MirCore/ITS-RaspberryCar/projektbericht/projektbericht.pdf

# 0.1 import

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

9
cap = cv2 . VideoCapture ( 0 ) | # Input 0
11 | # Codec und VideoWriter o b j e c t f ür Video Output
f o u r c c = cv2 . Vide oW ri te r_ f ou rcc (∗ ’XVID ’ )
13 out = cv2 . VideoWriter ( ’ output . a vi ’ , f o u r c c , 1 5 , ( 6 4 0 , 4 8 0 ) ) r e t , img = cap . re ad ( )

## ../main.py

## Am Anfang der Hauptdatei werden die benötigten Module importiert, gefolgt von den beiden

## ausgelagerten Dateien. Von aufrauemen.py werden nur die benötigten Funktionen importiert

und von setup.py wird alles importiert, da diese Datei keine Funktion enthält.

## In den Zeilen 10 bis 14 werden die benötigten Einstellungen für OpenCV 2 vorgenommen und

ein erstes Bild aufgenommen.

# 0.2 main

d e f main ( ) :
2 | l o s f a h r e n ( )
pr . s t a r t ( 0 ) | # Motor A, speed Tas tverh ä l t n i s
4 | pl . s t a r t ( 0 ) | # Motor B, speed Tas tverh ä l t n i s
6 | run_event = t h r e a di n g . Event ( )
run_event . s e t ( )

8
th1_delay = . 0 1 | # s l e e p dauer de r Funktion
10 | th2_delay = . 0 1 | # s l e e p dauer de r Funktion
th3_delay = . 0 0 1 | # s l e e p dauer de r Funktion
12 | th1 = t h r e a di n g . Thread ( t a r g e t=l i n i e n f a h r e n , a r g s =(th1_delay , run_event ) ) # Funktion i n
einem neuen Thread zuordnen
th2 = t h r e a di n g . Thread ( t a r g e t=checkblue , a r g s =(th2_delay , run_event ) ) # Funktion i n einem neuen Thread zuordnen
14 | th3 = t h r e a di n g . Thread ( t a r g e t=makevideo , a r g s =(th3_delay , run_event ) ) | # Funktion i n
einem neuen Thread zuordnen
16 | th3 . s t a r t ( ) | # Video Thread s t a r t e n
18 | no_green = 0
p r i n t ( "Warten au f g rüne Ampel " )

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

26
# Warten b i s S t r g+C ged rüc k t wird :

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

44
| cap . r e l e a s e ( )
46 | out . r e l e a s e ( )
48 | i f __name__ == ’__main__ ’ :
| main ( )

## ../main.py

## Das Programm wird in main gestartet und beendet. Als erstes werden die Motoren mit der

losfahren Funktion gestartet, allerdings noch mit einem Tastverhältnis von 0%. Anschließend wird das threading gestartet. Dafür wir wird run_event, das als while-Bedingung für die threads dient, gesetzt. Die delay-Angaben und die drei verwendeten threads th1, th2 und th3 werden definiert. target ist die Funktion die in dem neuen thread laufen soll und args sind die Variablen die mit übergeben werden. Die drei threads sind, linienfahren (der eigentliche lenk-Algorithmus), checkblue (der Test ob die Ampel blau leuchtet) und makevideo (die Videoausgabe).

Der erste thread, die Videoaufzeichnung, wird gestartet. Dann folgt eine while-Schleife die

## überprüft ob die Ampel grün ist. Wenn der zurückgegebene Wert der checkgreen Funktion

größer gleich 500 ist, also ausreichend Grünanteile erkannt wurden endet die Schleife. Dadurch werden die anderen beiden threads gestartet, wodurch das Auto losfährt.
Damit das Programm wieder beendet werden kann, folgt eine try-while und except Schleife, die weiter keine andere Funktion hat. Sobald ein KeyboardInterrupt durch das drücken von Strg-c

## auftritt wird das Auto gebremst und die threads werden geschlossen. Allerdings muss dabei

gewartet werden bis die while-Schleifen aller threads durchgelaufen sind. Anschließend werden die GPIO einstellungen bereinigt, die Videoaufnahme beendet und das Video gespeichert.

## Gestartet wird die main Funktion durch eine if __name__ == "__main__" abfrage, um die

Datei auch als Modul verwenden zu können.

# 0.3 line

1 d e f l i n e ( z e i l e N r ) :
g l o b a l img , r e t
3 | r e t , img = cap . re ad ( )
5 | img_r = img [ z eil e N r , : , 2 ] | # A l l e s aus z e i l e N r und B r ei t e und Farbkanal 2
img_g = img [ z eil e N r , : , 1 ]
7 | img_b = img [ z eil e N r , : , 0 ]
9 | z eil e _ bi n = ( img_r . a s t y p e ( ’ i n t 1 6 ’ ) − (img_g / 2 + img_b / 2 ) ) > 60 # R o t a n t eil übe r
Th re shold
11 | # Mi t telpun k t be rechnen und r e t u r n :
i f z eil e _ bi n . sum ( ) != 0 :
13 | x = np . a r an ge ( z eil e _ bi n . shape [ 0 ] ) | # x=0 ,1 ,2 . . . N−1 (N=Anzahl von Werten i n z eil e _ bi n
)
r e t u r n ( z eil e _ bi n ∗ x ) . sum ( ) / z eil e _ bi n . sum ( )
15 | e l s e :
r e t u r n None

## ../main.py

## In line wird ein Bild aufgenommen und, in einer Zeile, der Mittelpunkt der roten Anteile

ermittelt.
Der Funktion wird beim aufrufen die Zeile (zeileNr) übergeben, die auf den Rotwert analysiert werden soll. Damit wird es ermöglicht die selbe Funktion zum analysieren unterschiedlicher Zeilen zu verwenden. Das wird in der finalen Version aber nicht benutzt.
In Zeile 12 bis 16 wird der Mittelpunkt berechnet und zurückgegeben. Falls kein Rotanteil über dem Schwellwert liegt, wird None zurückgegeben.

# 0.4 linienfahren

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

39
p r i n t ( " " ∗ i n t ( mi t t e / 1 0 ) , "" , " " ∗ i n t ( 6 4 − mi t t e / 1 0 ) , " x = %.1 f " % mitte , " ; s t e e r = %.1 f " % s t e e r , " ; speed = %.1 f " % speed , " ; time = {: 0 > 2 }: {: 0 5. 2 f } " . format ( i n t ( minutes ) , s e c o n d s ) )
41 | p r i n t ( " " ∗ i n t ( i d e a l / 1 0 ) , " | " )
43 | time . s l e e p ( d el a y )

## ../main.py

## linienfahren ruft die Funktion line auf und berechnet die Lenkung und Geschwindigkeit aus

dem zurückgegebenen Wert.

## Am Anfang der Funktion wird ein Testbild aufgenommen und die für die Berechnung benö-

tigten Variablen erstellt. Danach folgt eine while Schleife, die bis zum Beenden des threading durchläuft. Falls keine rote Linie im Bild war, oder in seltenen Fällen, wenn die Linie nicht erkannt wurde, gibt line None zurück. In diesem Fall wird, in den Zeilen 17 bis 21, überprüft ob die Linie zuletzt rechts oder links im Bild war. Der Messwert mitte wird dementsprechend

## auf das Minimum (0) oder das Maximum (640) gesetzt. Anschließend wird der Wert für die

Videoausgabe abgespeichert (Zeile 22).
In den Zeilen 24 bis 33 wird der Wert für die Lenkung und Geschwindigkeit berechnet. Unterschieden wird zwischen drei Fällen. Ist der Messwert in der Mitte des Bildes wird geradeaus

## gelenkt, andernfalls wird die Lenkung und die Geschwindigkeit berechnet. Ist der Messwert

größer als der Bildmittelpunkt wird 2 − Lenkwert gerechnet. Es ergibt sich ein Lenkwert zwischen 0 und 1 für eine Linkskurve und 1 bis 2 für eine Rechtskurve. Das hat den Vorteil,

## dass der lenken Funktion nicht zusätzlich eine Richtungsangabe übergeben werden muss. An-

schließend wird die lenken Funktion mit den Lenk- und Geschwindigkeits-Variablen aufgerufen .

## Der Wert für die Lenkung und die Geschwindigkeit wird aus dem Messwert und dem Bildmit-

## telpunkt berechnet:

## Lenkung =

## Messwert

Bildmittelpunkt · 90% + 10% | (1)

## Geschwidigkeit =

## Messwert

Bildmittelpunkt · 60% + 40% | (2)

Damit die Lenkung nicht zu stark ist, wird der Wert kleiner gewichtet (·90%) und angehoben

## (+10%). So startet der Wert nicht bei 0% sondern bei 10%. Die Geschwindigkeit wird gleich

## berechnet, allerdings mit (·60%) gewichtet und (+40%) angehoben. Es wird also mit 60% bis

100% Geschwindigkeit gefahren.

Für die Text- und Videoausgabe wird die verstrichene Zeit berechnet. Anschließend folgt in

## Zeile 40/41 eine Textausgabe über die Konsole. Dabei werden Messwert 10 Leerzeichen, dann ein Blockzeichen als Position des Messpunktes im Bild und die verbleibenden 64 −

Messwert

## 10 Leerzei-

## chen geschrieben. Dann folgen noch Angaben zu Messpunkt, Lenkwert, Geschwindigkeit und

Zeit. In der nächsten Zeile wird der Mittelpunkt mit einem Strich markiert. Es ergibt sich eine

## Textausgabe die zum Beispiel so aussieht:

| x = 2 4 5 . 0 | ; s t e e r = 0 . 8 | ; sp e ed = 8 5 . 9 | ; t im e = 0 0 : 0 0 . 0 0
| x = 2 6 5 . 0 | ; s t e e r = 0 . 8 | ; sp e ed = 8 9 . 7 | ; t im e = 0 0 : 0 0 . 0 4
| x = 2 8 4 . 0 | ; s t e e r = 0 . 9 | ; sp e ed = 9 3 . 2 | ; t im e = 0 0 : 0 0 . 0 8
| x = 2 9 2 . 0 | ; s t e e r = 0 . 9 | ; sp e ed = 9 4 . 8 | ; t im e = 0 0 : 0 0 . 1 2
| x = 3 0 4 . 0 | ; s t e e r = 1 . 0 | ; sp e ed = 9 7 . 0 | ; t im e = 0 0 : 0 0 . 1 6
| x = 3 1 2 . 0 | ; s t e e r = 1 . 0 | ; sp e ed = 9 8 . 5 | ; t im e = 0 0 : 0 0 . 2 0
| x = 3 2 5 . 0 | ; s t e e r = 1 . 0 | ; sp e ed = 9 9 . 1 | ; t im e = 0 0 : 0 0 . 2 4

# 0.5 lenken

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

10
| speedHead = ( 1 0 0 − speed )

12
| i f speedHead > speed :
14 | speedHead = speed
16 | i f s t e e r == 1 :
| pr . ChangeDutyCycle ( speed )
18 | pl . ChangeDutyCycle ( speed )
| e l i f s t e e r < 1 :
20 | pr . ChangeDutyCycle ( ( ( 1 − s t e e r ) ∗ speedHead + speed ) ) # r e c h t e Motoren
| pl . ChangeDutyCycle ( s t e e r ∗ speed ) # l i n k e Motoren
22 | e l i f s t e e r > 1 :
| s t e e r = 2 − s t e e r # s t e e r au f 0−1 n o rmie ren
24 | pr . ChangeDutyCycle ( ( s t e e r ∗ speed ) ) # r e c h t e Motoren
| pl . ChangeDutyCycle ( ( ( 1 − s t e e r ) ∗ speedHead + speed ) ) # l i n k e Motoren

26 | r e t u r n

## ../main.py

## Die lenken Funktion steuert das Tastverhältnis der Motoren. Übergeben werden zwei Parame-

## ter für die Lenkgewichtung und die Geschwindigkeit. Am Anfang der Funktion werden einige

## Abfragen zur Fehlerverhütung vorgenommen, damit das Tastverhältnis nicht unter 0% oder

über 100% liegt, dass würde sonst zu einem Absturz führen.

## Damit das Auto in den Kurven nicht ungewollt langsamer fährt, wird ausgerechnet wie viel

schneller sich die äußeren Motoren drehen können.

| Kopfraum = 100 − Geschwindigkeit | (3)

Ist der Kopfraum größer als der Geschwindigkeitswert, wird der Kopfraum gleich der Geschwindigkeit gesetzt.

## Die Tastverhältnisse der Motoren werden gleich dem Geschwindigkeitswert gesetzt, wenn der

Lenkwert steer = 1 ist. Sonst wird unterschieden ob der Lenkwert größer oder kleiner als 1 ist, um in die entsprechende Richtung zu lenken.

Innere Motoren: | Tastverhältnis = Lenkwert · Geschwindigkeit | (4)
Äußere Motoren: | Tastverhältnis = (1 − Lenkwert) · Kopfraum + Geschwindigkeit | (5)

## Die Kombination aus dem Lenkwert, Geschwindigkeitswert und Kopfraum ermöglicht ein stu-

fenloses kurven fahren, ohne das an Geschwindigkeit verloren wird. Dabei ist es egal worauf die Werte basieren, es wird immer gleich sanft gelenkt.

## Tabelle 1: Beispielwerte für die Motorensteuerung

Lenken | Geschwindigkeit | Tinnen[%] | Taussen[%]
0,2 | 20 | 2 | 36
| 60 | 12 | 92
| 80 | 16 | 96
0,8 | 20 | 16 | 24
| 60 | 48 | 68
| 80 | 64 | 84

# 0.6 checkgreen

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

3
| # Take each frame

5 | r e t , img = cap . re ad ( )
7 | # Convert BGR t o HSV hsv = cv2 . c v tC ol o r ( img , cv2 .COLOR_BGR2HSV)

9
| lowe r_g reen = np . a r r a y ( [ 4 5 , 2 0 0 , 2 0 0 ] )
11 | upper_green = np . a r r a y ( [ 8 0 , 2 5 5 , 2 5 5 ] )
13 | mask = cv2 . inRange ( hsv , lower_green , upper_green )
| no_green = cv2 . countNonZero (mask )
15 | r e t u r n no_green

## ../main.py

Die checkgreen Funktion Analysiert ein ganzes Bild der Webcam auf ihren Grünanteil und gibt die Anzahl zurück.

# 0.7 checkblue

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

4
| w hil e run_event . i s _ s e t ( ) :
6 | # Convert BGR t o HSV hsv = cv2 . c v tC ol o r ( img , cv2 .COLOR_BGR2HSV)

8
| lowe r_blue = np . a r r a y ( [ 9 0 , 1 0 0 , 2 5 5 ] )
10 | upper_blue = np . a r r a y ( [ 1 0 0 , 2 5 5 , 2 5 5 ] )
12 | mask = cv2 . inRange ( hsv , lower_blue , upper_blue )
| no_blue = cv2 . countNonZero (mask )
14 | i f no_blue > 5 0 0: p r i n t ( " Blaue Ampel , warte 1 , 5 sekunden . . . " )
16 | time . s l e e p ( 1 . 5 )
| bremsen ( )
18 | p r i n t ( "STOP ! ! ! Rennen f e r t i g " )
| run_event . c l e a r ( )

20
| time . s l e e p ( d el a y )

## ../main.py

checkblue funktioniert ähnlich wie checkblue, allerdings läuft die Funktion in Dauerschleife und

## stoppt das Auto 1,5 Sekunden nachdem die blaue Ampel erkannt wurde. Die Funktion nimmt

dabei kein eigenes Bild auf, sondern verwendet das Bild, dass von den linienfahren Funktion

## aufgenommen wurde. Beim starten des threads wird wartet die Funktion eine Sekunde, damit

nicht die grüne Ampel fälschlicher weise als Stopsignal erkannt wird.

# 0.8 makevideo

1 | d e f makevideo ( delay , run_event ) :
| g l o b a l img , r e t , out

3 | g l o b a l x , minutes , s e c o n d s
5 | minutes = 0
| s e c o n d s = 0
7 | f o n t = cv2 .FONT_HERSHEY_SIMPLEX
| x = 320
9 | c ap tu re_ vide o = True
11 | w hil e run_event . i s _ s e t ( ) :
| i f r e t==True and c ap tu re_vide o == True :
13 | cv2 . l i n e ( img , ( i n t ( x ) −1 ,70) , ( i n t ( x ) +1 ,70) , ( 2 5 5 , 0 , 0 ) , 5 )
| cv2 . putText ( img , ’ {: 0 > 2 }: {: 0 5. 2 f } ’ . fo rmat ( i n t ( minutes ) , s e c o n d s ) , ( 1 0 , 4 7 0 ) , f on t ,
| 2 , ( 2 5 5 , 2 5 5 , 2 5 5 ) , 2 , cv2 .LINE_AA)
15 | cv2 . putText ( img , " %.0 f " % x , ( i n t ( x ) −30 ,100) , f on t , 1 , ( 2 5 5 , 2 5 5 , 2 5 5 ) , 2 , cv2 .LINE_AA)
| out . w ri t e ( img )
17 | time . s l e e p ( d el a y )

## ../main.py

## Die Aufgabe der makevideo Funktion ist es die von der Kamera aufgenommenen Bilder als

ein Video zu exportieren. Da das Video nur zur Fehleranalyse und Veranschaulichung dient, wird es vernachlässigt ob das Video in Echtzeit läuft. Dafür wird die aktuelle Fahrzeit, ab dem erkennen der grünen Ampel, unten links im Bild eingeblendet. Außerdem wird der zu dem Bild gehörende Messpunkt und dessen Wert eingezeichnet.

## Das Video in Zusammenhang mit den eingeblendeten Werten ermöglicht eine deutlich bessere

Fehleranalyse als eine Textausgabe über die Konsole (Abb.: 1).


## Abbildung 1: Kamerabild mit Zeitanzeige und Messpunkt, abgelenkt von einem roten Schuh

# 0.9 setup.py

1 | import RPi .GPIO a s GPIO # GPIO−Bi bli o t h e k im p o r ti e r e n
3 | GPIO. setmode (GPIO.BCM) | # Verwende BCM−Pinnummern
5 | # GPIO f ür Motoren

# Motor A

7 | ENA = 10 | # Enable Motor A
IN1 = 9 | # In 1
9 | IN2 = 11 | # In 2
# Motor B

11 | ENB = 22 | # Enable Motor B
IN3 = 17 | # In 3
13 | IN4 = 27 | # In 4
15 | # GPIOs a l s Ausgang s e t z e n
GPIO. s e tup (ENA, GPIO.OUT) 17 GPIO. s e tup ( IN1 , GPIO.OUT) GPIO. s e tup ( IN2 , GPIO.OUT) 19 GPIO. s e tup (ENB, GPIO.OUT) GPIO. s e tup ( IN3 , GPIO.OUT)
21 | GPIO. s e tup ( IN4 , GPIO.OUT)
23 | # PWM f ür Motor A und B
pr = GPIO.PWM(ENA, 7 3 ) | # Motor A, Frequenz = 73 Hz
25 | pl = GPIO.PWM(ENB, 7 3 ) | # Motor B, Frequenz = 73 Hz
27 | GPIO. output ( IN1 , 0 ) | # Bremsen
GPIO. output ( IN2 , 0 ) | # Bremsen
29 | GPIO. output ( IN3 , 0 ) | # Bremsen
GPIO. output ( IN4 , 0 ) | # Bremsen

31
p r i n t ( "GPIO−Setup e r f o l g r e i c h " )

## ../setup.py

In setup.py werden die GPIOs definiert und wird am Anfang von main.py aufgerufen. Verwendet wird der BCM Modus. Für die PWM wurde eine Frequenz von 73 Hz gewählt.

# 0.10 aufraeumen.py

import RPi .GPIO a s GPIO # GPIO−Bi bli o t h e k im p o r ti e r e n
2 | import time | # Modul time
| from se tup import ∗

4
| d e f au fraeumen ( ) :
6 | # E r s t bremsen dann cle anup
| GPIO. output ( IN1 , 0 ) | # Bremsen
8 | GPIO. output ( IN2 , 0 ) | # Bremsen
| GPIO. output ( IN3 , 0 ) | # Bremsen
10 | GPIO. output ( IN4 , 0 ) | # Bremsen
| time . s l e e p ( . 1 )
12 | GPIO. cle anup ( ) | # Au fr äumen
p r i n t ( "GPIOs a u f g e r äumt " )

14
| d e f bremsen ( ) :
16 | GPIO. output ( IN1 , 0 ) | # Bremsen
| GPIO. output ( IN2 , 0 ) | # Bremsen
18 | GPIO. output ( IN3 , 0 ) | # Bremsen
| GPIO. output ( IN4 , 0 ) | # Bremsen

20
| d e f l o s f a h r e n ( ) :
22 | GPIO. output ( IN1 , 1 ) | # Motor A R e c h t sl a u f
| GPIO. output ( IN2 , 0 ) | # Motor A R e c h t sl a u f

24 | GPIO. output ( IN3 , 1 ) | # Motor B R e c h t sl a u f
| GPIO. output ( IN4 , 0 ) | # Motor B R e c h t sl a u f

## ../aufraeumen.py

In aufrauemen.py sind drei Funktionen ausgelagert. losfahren setzt die vier GPIOs der Motoren

## auf die entsprechenden Werte zum Vorwärtsfahren, bremsen setzt die GPIOs, zum stoppen des

Autos, auf null und aufrauemen stoppt das Auto und bereinigt die GPIO Einstellungen.

# 1 Anhang

# 1.1 main.py

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

9
cap = cv2 . VideoCapture ( 0 ) | # Input 0
11 | # Codec und VideoWriter o b j e c t f ür Video Output
f o u r c c = cv2 . Vide oW ri te r_ f ou rcc (∗ ’XVID ’ )
13 out = cv2 . VideoWriter ( ’ output . a vi ’ , f o u r c c , 1 5 , ( 6 4 0 , 4 8 0 ) ) r e t , img = cap . re ad ( )

15
# Video e r s t e l l e n

17 d e f makevideo ( delay , run_event ) : g l o b a l img , r e t , out
19 | g l o b a l x , minutes , s e c o n d s
21 | minutes = 0
s e c o n d s = 0
23 | f o n t = cv2 .FONT_HERSHEY_SIMPLEX
x = 320
25 | c ap tu re_ vide o = True
27 | w hil e run_event . i s _ s e t ( ) :
i f r e t==True and c ap tu re_vide o == True :
29 | cv2 . l i n e ( img , ( i n t ( x ) −1 ,70) , ( i n t ( x ) +1 ,70) , ( 2 5 5 , 0 , 0 ) , 5 )
cv2 . putText ( img , ’ {: 0 > 2 }: {: 0 5. 2 f } ’ . fo rmat ( i n t ( minutes ) , s e c o n d s ) , ( 1 0 , 4 7 0 ) , f on t , 2 , ( 2 5 5 , 2 5 5 , 2 5 5 ) , 2 , cv2 .LINE_AA)
31 | cv2 . putText ( img , " %.0 f " % x , ( i n t ( x ) −30 ,100) , f on t , 1 , ( 2 5 5 , 2 5 5 , 2 5 5 ) , 2 , cv2 .LINE_AA)
out . w ri t e ( img )
33 | time . s l e e p ( d el a y )
35 | # Schauen , ob Ampel g rün i s t
d e f c h e c k g r e e n ( ) :
37 | g l o b a l img , r e t
39 | # Take each frame
r e t , img = cap . re ad ( )

41

# Convert BGR t o HSV

43 | hsv = cv2 . c v tC ol o r ( img , cv2 .COLOR_BGR2HSV)
45 | lowe r_g reen = np . a r r a y ( [ 4 5 , 2 0 0 , 2 0 0 ] )
| upper_green = np . a r r a y ( [ 8 0 , 2 5 5 , 2 5 5 ] )

47
| mask = cv2 . inRange ( hsv , lower_green , upper_green )
49 | no_green = cv2 . countNonZero (mask )
| r e t u r n no_green

51
| # Schauen , ob Ampel bl au i s t
53 | d e f c h e c k bl u e ( delay , run_event ) :
| g l o b a l img , r e t
55 | time . s l e e p ( 1 )
57 | w hil e run_event . i s _ s e t ( ) :
| # Convert BGR t o HSV
59 | hsv = cv2 . c v tC ol o r ( img , cv2 .COLOR_BGR2HSV)
61 | lowe r_blue = np . a r r a y ( [ 9 0 , 1 0 0 , 2 5 5 ] )
| upper_blue = np . a r r a y ( [ 1 0 0 , 2 5 5 , 2 5 5 ] )

63
| mask = cv2 . inRange ( hsv , lower_blue , upper_blue )
65 | no_blue = cv2 . countNonZero (mask )
| i f no_blue > 5 0 0:
67 | p r i n t ( " Blaue Ampel , warte 1 , 5 sekunden . . . " )
| time . s l e e p ( 1 . 5 )
69 | bremsen ( )
| p r i n t ( "STOP ! ! ! Rennen f e r t i g " )
71 | run_event . c l e a r ( )
73 | time . s l e e p ( d el a y )
75 | # Motoren l e n k e n
| d e f l e n k e n ( s t e e r , speed ) :
77 | i f s t e e r > 2 :
| s t e e r = 2
79 | e l i f s t e e r < 0 :
| s t e e r = 0
81 | i f speed > 1 0 0:
| speed = 100
83 | e l i f speed < 0 :
| speed = 0

85
| speedHead = ( 1 0 0 − speed )

87
| i f speedHead > speed :
89 | speedHead = speed
91 | i f s t e e r == 1 :
| pr . ChangeDutyCycle ( speed )
93 | pl . ChangeDutyCycle ( speed )
| e l i f s t e e r < 1 :
95 | pr . ChangeDutyCycle ( ( ( 1 − s t e e r ) ∗ speedHead + speed ) ) # r e c h t e Motoren
| pl . ChangeDutyCycle ( s t e e r ∗ speed ) # l i n k e Motoren
97 | e l i f s t e e r > 1 :
| s t e e r = 2 − s t e e r # s t e e r au f 0−1 n o rmie ren
99 | pr . ChangeDutyCycle ( ( s t e e r ∗ speed ) ) # r e c h t e Motoren
| pl . ChangeDutyCycle ( ( ( 1 − s t e e r ) ∗ speedHead + speed ) ) # l i n k e Motoren
101 | r e t u r n

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

107
img_r = img [ z eil e N r , : , 2 ] | # A l l e s aus z e i l e N r und B r ei t e und Farbkanal 2
109 | img_g = img [ z eil e N r , : , 1 ]
img_b = img [ z eil e N r , : , 0 ]

111
z eil e _ bi n = ( img_r . a s t y p e ( ’ i n t 1 6 ’ ) − (img_g / 2 + img_b / 2 ) ) > 60 # R o t a n t eil übe r Th re shold

113
# Mi t telpun k t be rechnen und r e t u r n :

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

155
l e n k e n ( s t e e r , speed )

157
hours , rem = divmod ( time . time ( )−s t a r t z e i t , 3 6 0 0 )
159 | minutes , s e c o n d s = divmod ( rem , 6 0 )

161 | p r i n t ( " " ∗ i n t ( mi t t e / 1 0 ) , "" , " " ∗ i n t ( 6 4 − mi t t e / 1 0 ) , " x = %.1 f " % mitte , " ; s t e e r
= %.1 f " % s t e e r , " ; speed = %.1 f " % speed , " ; time = {: 0 > 2 }: {: 0 5. 2 f } " . format ( i n t ( minutes ) , s e c o n d s ) )
p r i n t ( " " ∗ i n t ( i d e a l / 1 0 ) , " | " )

163
time . s l e e p ( d el a y )

165
# Programm s t a r t e n

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

171
run_event = t h r e a di n g . Event ( )
173 | run_event . s e t ( )
175 | th1_delay = . 0 1 | # s l e e p dauer de r Funktion
th2_delay = . 0 1 | # s l e e p dauer de r Funktion
177 | th3_delay = . 0 0 1 | # s l e e p dauer de r Funktion
th1 = t h r e a di n g . Thread ( t a r g e t=l i n i e n f a h r e n , a r g s =(th1_delay , run_event ) ) # Funktion i n einem neuen Thread zuordnen
179 | th2 = t h r e a di n g . Thread ( t a r g e t=checkblue , a r g s =(th2_delay , run_event ) ) | # Funktion i n
einem neuen Thread zuordnen
th3 = t h r e a di n g . Thread ( t a r g e t=makevideo , a r g s =(th3_delay , run_event ) ) # Funktion i n einem neuen Thread zuordnen

181
th3 . s t a r t ( ) # Video Thread s t a r t e n

183
no_green = 0
185 | p r i n t ( "Warten au f g rüne Ampel " )
187 | w hil e no_green < 5 0 0:
no_green = c h e c k g r e e n ( )

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

213 i f __name__ == ’__main__ ’ :
215 | main ( )

## ../main.py
