MirCore/ITS-RaspberryCar/projektbericht/HAW_Logo-eps-converted-to.pdf

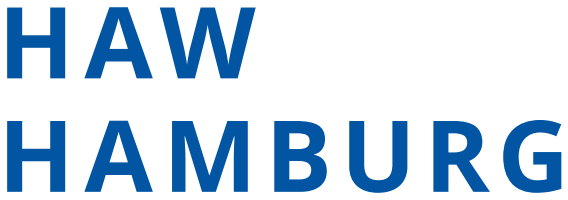
[picture p17: figure]
