MirCore/ITS-RaspberryCar/3D-Druck_Modelle/Kamerahalterung_alt.png

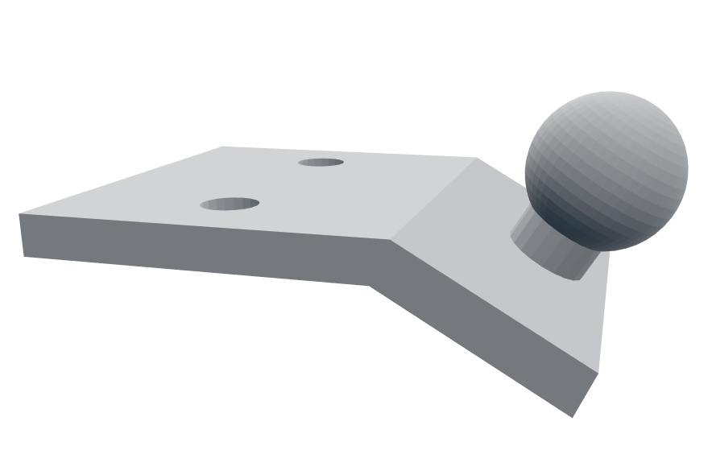
3D-Druck_Modelle/Kamerahalterung_alt.png
