MirCore/ITS-RaspberryCar/projektbericht/Schaltplan_Steckplatine.png

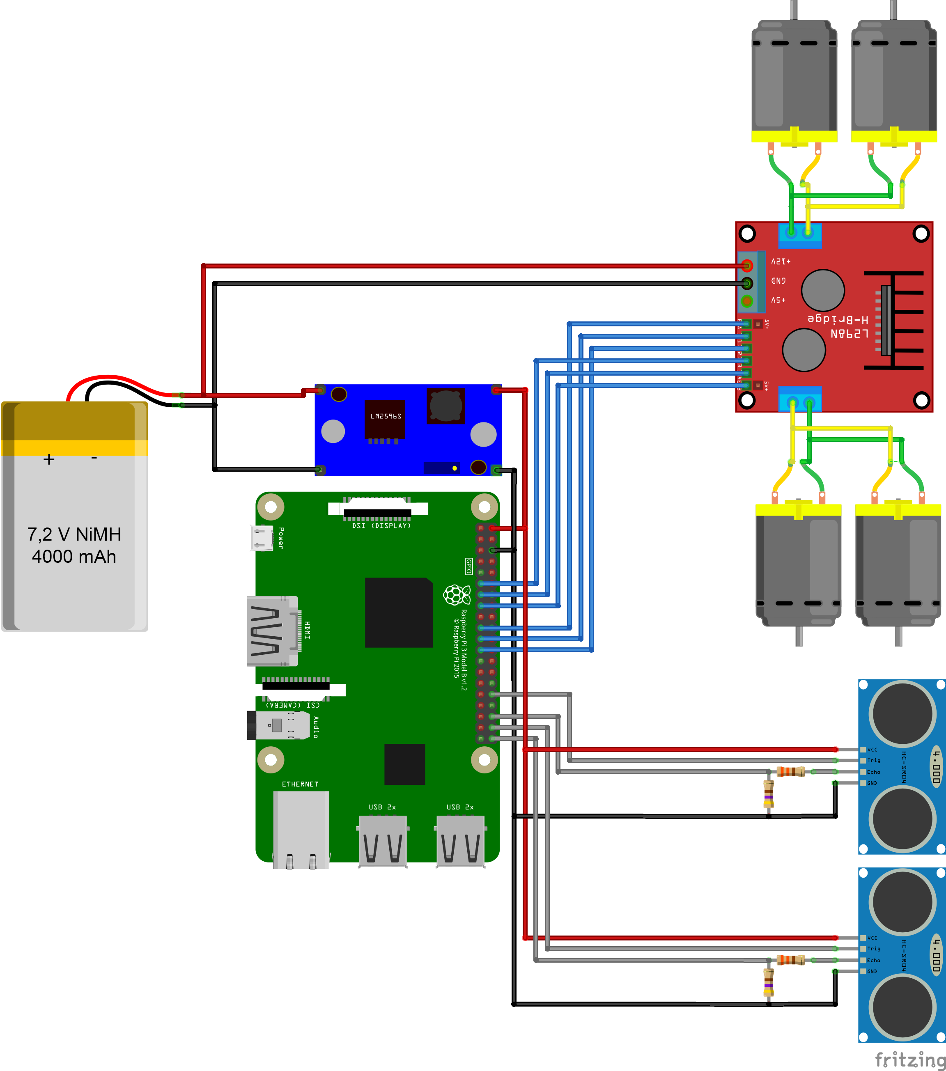
projektbericht/Schaltplan_Steckplatine.png
