MirCore/ITS-RaspberryCar/3D-Druck_Modelle/Kamerahalterung Neu.stl

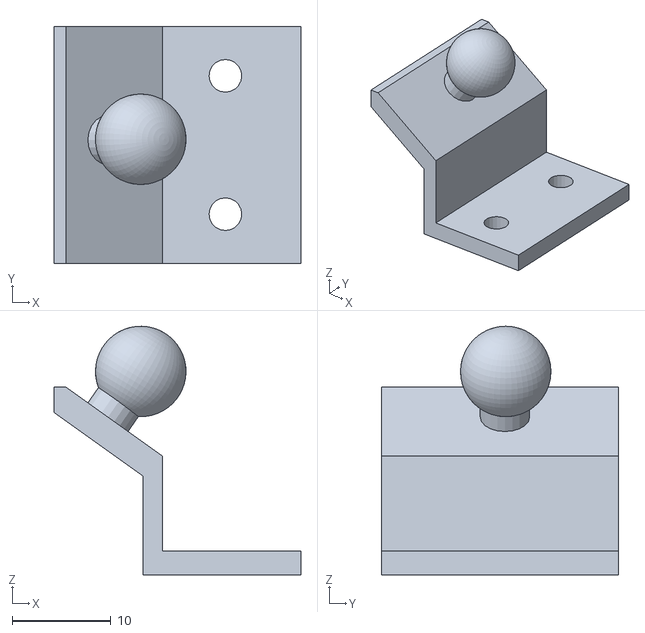
[picture p20: CAD file, 2018-02-13]
3D-Druck_Modelle/Kamerahalterung Neu.stl
25.0 x 24.0 x 25.2
