MirCore/ITS-RaspberryCar/3D-Druck_Modelle/Sensor.stl

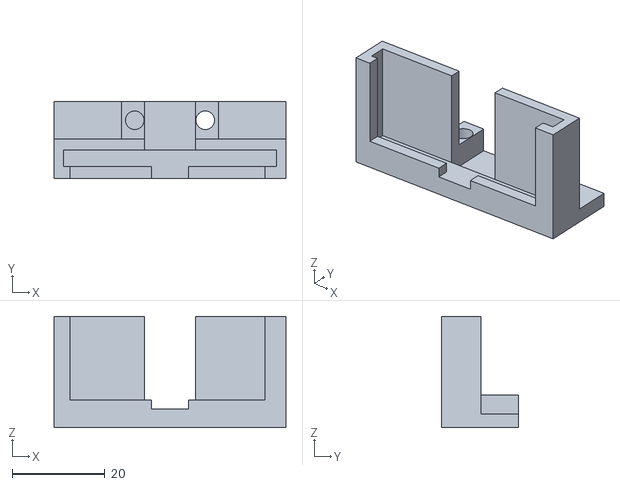
[picture p21: CAD file, 2018-02-04]
3D-Druck_Modelle/Sensor.stl
50.0 x 16.5 x 24.0
