MirCore/ITS-RaspberryCar/3D-Druck_Modelle/Cam-Halterung_STL.stl

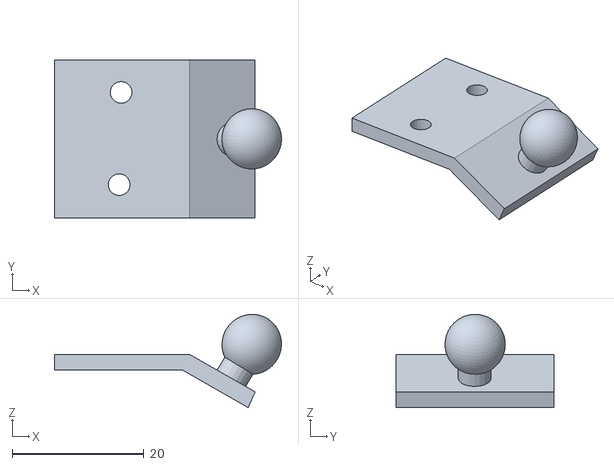
[picture p22: CAD file, 2017-12-12]
3D-Druck_Modelle/Cam-Halterung_STL.stl
34.5 x 24.0 x 14.2
