MirCore/ITS-RaspberryCar/(list of files, cad)

Other CAD files:
3D-Druck_Modelle/Sensor.blend
