MirCore/ITS-RaspberryCar/testbilder/test.png

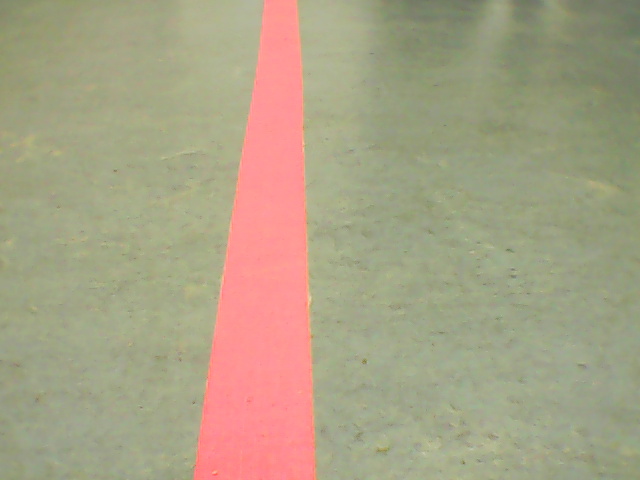
testbilder/test.png
