MirCore/ITS-RaspberryCar/projektbericht/Schaltplan.pdf

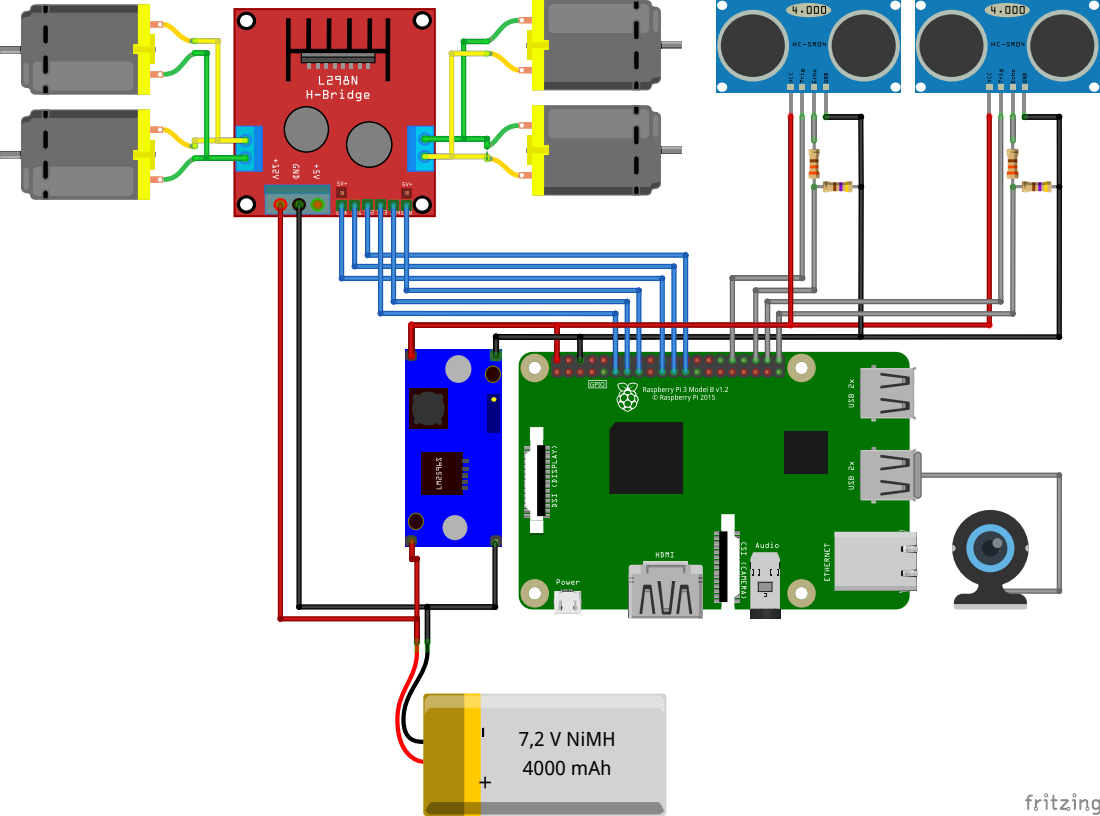
[picture p24: page 1]
7,2 V NiMH 4000 mAh
