MirCore/ITS-RaspberryCar/projektbericht/Testbild-eps-converted-to.pdf

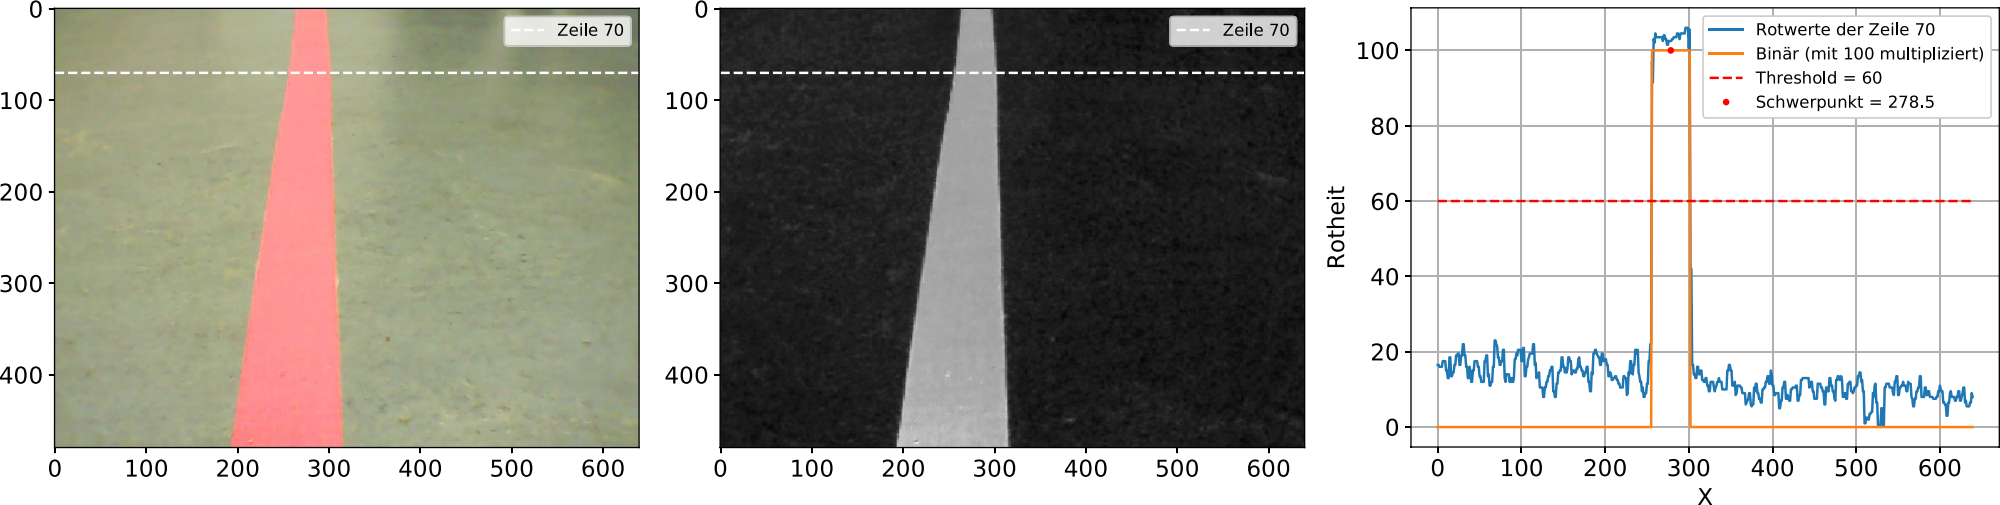
[picture p25: page 1]
