MirCore/ITS-RaspberryCar/(list of files, drawings)

Other design files:
projektbericht/Schaltplan.fzz
