MirCore/ITS-RaspberryCar/challenges/generalprobe/main.py

import threading  # Modul threads
import cv2  # Dies ist die Bildverarbeitungsbibliothek OpenCV
import numpy as np  # Rechnen mit vielen Zahlen in einem Array (z. B. Bilder)
import math
import time  # Modul time
import statistics
import os

from aufraeumen import aufraeumen, losfahren, bremsen  # Funktion für cleanup() importieren
from setup import *  # GPIO Setup importieren und ausführen
from abstand import distanz  # Funktion für Wandabstand messen importieren

speed = 4  # 1 bis 4 (*25% Tastverhältnis)
linie_found = True

cap = cv2.VideoCapture(0)  # Input 0
capture_video = False

# Define the codec and create VideoWriter object
fourcc = cv2.VideoWriter_fourcc(*'XVID')
out = cv2.VideoWriter('output.avi',fourcc, 20.0, (640,480))

def line(zeileNr1):
    ret, img = cap.read()
    
    if ret==True and capture_video == True:
        out.write(img)

    img_red = img[zeileNr1, :, 2]  # Alles aus der Dimension Höhe und Breite (:,:) und den Farbkanal 2
    img_green = img[zeileNr1, :, 1]
    img_blue = img[zeileNr1, :, 0]

    zeile_bin = (img_red.astype('int16') - (img_green / 2 + img_blue / 2)) > 60

    # Mittelpunkt berechnen:
    if zeile_bin.sum() != 0:
        x = np.arange(zeile_bin.shape[0])  # x=0,1,2 ... N-1 (N=Anzahl von Werten in zeile400_bin)
        return (zeile_bin * x).sum() / zeile_bin.sum()
    else:
        return None

def lenken(steer):
    if steer > 2:
        steer = 2
    if steer < 0:
        steer = 0
    speedHead = (100 - speed * 25) / 25
    if speedHead > 2:
        speedHead = 2
    if steer == 1:
        pr.ChangeDutyCycle(speed * 25)  #
        pl.ChangeDutyCycle(speed * 25)  #
    elif steer < 1:
        pr.ChangeDutyCycle(((1 - steer) * speedHead + speed) * 25)  #
        pl.ChangeDutyCycle(steer * speed * 25)  #
    elif steer > 1:
        steer = 2 - steer
        pr.ChangeDutyCycle(steer * speed * 25)  #
        pl.ChangeDutyCycle(((1 - steer) * speedHead + speed) * 25)  #
    return

def linienfahren(delay, run_event):
    global speed
    global cap
    global linie_found

    ret, img = cap.read()
    width = np.size(img, 1)
    ideal = width / 2
    mitte = ideal
    steer = 1
    i = 1
    linie_found_counter = 0

    while run_event.is_set():
        last_mitte = mitte
        mitte = line(100)
        i+=1
        
        if linie_found is True: 
            if mitte is None:
                speed = 1.5
                if last_mitte > ideal:
                    mitte = 640
                else:
                    mitte = 0
            elif width/4 < mitte < width/4*3:
                speed = 4
            else:
                speed = 2

            if mitte == ideal:
                steer = 1
            elif mitte < ideal:
                steer = (mitte/ideal)*.7+.3
            elif mitte > ideal:
                steer = 2-(((width-mitte)/ideal)*.7+.3)

            lenken(steer)
            print(" " * int(mitte/10), "█", " " * int(30 - mitte/10), "x = %.1f cm" % mitte, ";ideal = %.1f" % ideal, ";steer = %.1f" % steer, ";i = ", i)
            print(" " * int(ideal/10), "|")

        time.sleep(delay)
        
def wandfahren(delay, run_event):
    global speed
    global linie_found

    zielDist = 25
    dist = distanz("L")
    steer = 1
    print("Distanz: ", dist)

    while run_event.is_set():
        speed = 4
        lastDist = dist
        lastSteer = steer
        dist = distanz("L")

        zielAngle = math.degrees(-math.atan((zielDist - dist) / 20))  # Winkel zum ziel-Abstand
        angle = math.degrees(math.atan((lastDist - dist) / 10))  # Vermutlicher Winkel des Autos zur Wand

        if zielAngle == angle:
            steer = 1
        elif angle < zielAngle:
            steer = ((angle + 90) / (zielAngle + 90)) ** speed
        elif angle > zielAngle:
            steer = 2 - (((zielAngle + 90) / (angle + 90)) ** speed)

        steer = (lastSteer + steer) / 2
        
        if linie_found == False:
            lenken(steer)
            print(" " * int(dist), "█", " " * int(70 - dist), "d = %.1f cm" % dist, ";s = %.2f" % steer, ";a = %.1f°" % angle,
              ";z = %.1f°" % zielAngle)
            print(" " * zielDist, "|")

        time.sleep(delay)

def main():
    global speed
    
    losfahren()
    pr.start(speed)  # Motor A, speed% Tastverhältnis
    pl.start(speed)  # Motor B, speed% Tastverhältnis

    run_event = threading.Event()
    run_event.set()

    th1_delay = .01   # sleep dauer der Funktion
    th2_delay = .01  # sleep dauer der Funktion
    th1 = threading.Thread(target=linienfahren, args=(th1_delay, run_event))  # Funktion in einem neuen Thread zuordnen
    th2 = threading.Thread(target=wandfahren, args=(th2_delay, run_event))  # Funktion in einem neuen Thread zuordnen

    th1.start()  # Thread starten
    th2.start()  # Thread starten

    # Warten bis Strg+C gedrückt wird:
    try:
        while 1:
            time.sleep(.01)

    except KeyboardInterrupt:
        print("attempting to close threads. Max wait =", max(th1_delay, th2_delay))  #
        bremsen()
        run_event.clear()
        th1.join()
        print("th1 closed")
        th2.join()
        print("th2 closed")
        aufraeumen()
        print("threads successfully closed")
        
        cap.release()
        out.release()
        
if __name__ == '__main__':
    main()
