MirCore/ITS-RaspberryCar/(commit log)

2017-10-17 Raspberry Test initial commit
2017-11-17 RaspberryCar Ordner hinzugefügt Multithreading hinzugefügt Auf mehrere files aufgeteilt Programmiert ohne Pi - GPIOs auskommentiert
2017-12-12 Code Cleanup
    [Cam-Halterung_STL.stl]
2017-12-12 linienfahren 12.12.
    [Cam-Halterung_STL.stl]
2018-02-04 Raspberry Pi Test Datei gelöscht
2018-02-04 Sensor Modell zu GitHub hinzugefügt
    [Sensor.blend, Sensor.stl]
2018-02-04 Ornder umbenannt
    [Cam-Halterung_STL.stl, Sensor.blend, Sensor.stl]
2018-02-04 Ordner umbenannt
    [Cam-Halterung_STL.stl, Sensor.blend, Sensor.stl]
2018-02-09 Schaltplan hinzugefügt
    [Schaltplan.fzz]
2018-02-09 import und makevideo Text hinzugefügt
2018-02-09 Bild hinzugefügt
    [Schaltplan.fzz]
2018-02-12 Create Projektvorstellung_usw_Google-Drive-Link
    Einleitung, Projektvorstellung, Anforderungen und technische Rahmenbedingungen
2018-02-15 Datei umbenannt und zurechtgeschnitten
2018-02-19 Fehlerkorrkektur und Ergänzungen
2018-02-20 Finaler Projektbericht
    [Schaltplan.fzz]
2018-02-20 Hochladen des Projekberichts als PDF
